TheoMaillot/ECG-Monitoring-System/firmware/project-STM32CubeIDE/PROJET-ECG-IHM/PROJET-ECG-IHM.ioc

Mcu.UserName=STM32L432KCUx
PA10.Signal=USART1_RX
PA9.Signal=USART1_TX
PB0.GPIO_Label=SIGNAL
PB0.Signal=ADCx_IN15
PB1.GPIO_Label=LED
PB1.Signal=GPIO_Output
PB5.Signal=SPI3_MOSI
