TheoMaillot/ECG-Monitoring-System/firmware/inc/main.h

#define SIGNAL_Pin GPIO_PIN_0
#define SIGNAL_GPIO_Port GPIOB
#define LED_Pin GPIO_PIN_1
#define LED_GPIO_Port GPIOB
#define NSS_Pin GPIO_PIN_15
#define NSS_GPIO_Port GPIOA
