TheoMaillot/ECG-Monitoring-System/(notices)

Notices in the files:
firmware/project-STM32CubeIDE/PROJET-ECG-IHM/Core/Inc/main.h:
Copyright (c) 2025 STMicroelectronics.
All rights reserved.
This software is licensed under terms that can be found in the LICENSE file
